pit3k/domofon-esp32/hardware/pcb/drc-report.txt

** Drc report for domofon.kicad_pcb **
** Created on 2026-10-20T21:28:56+0200 **

** Found 0 DRC violations **

** Found 0 unconnected pads **

** Found 0 Footprint errors **

** End of Report **
