pit3k/domofon-esp32/cnc/previews/toolpaths_overview.png

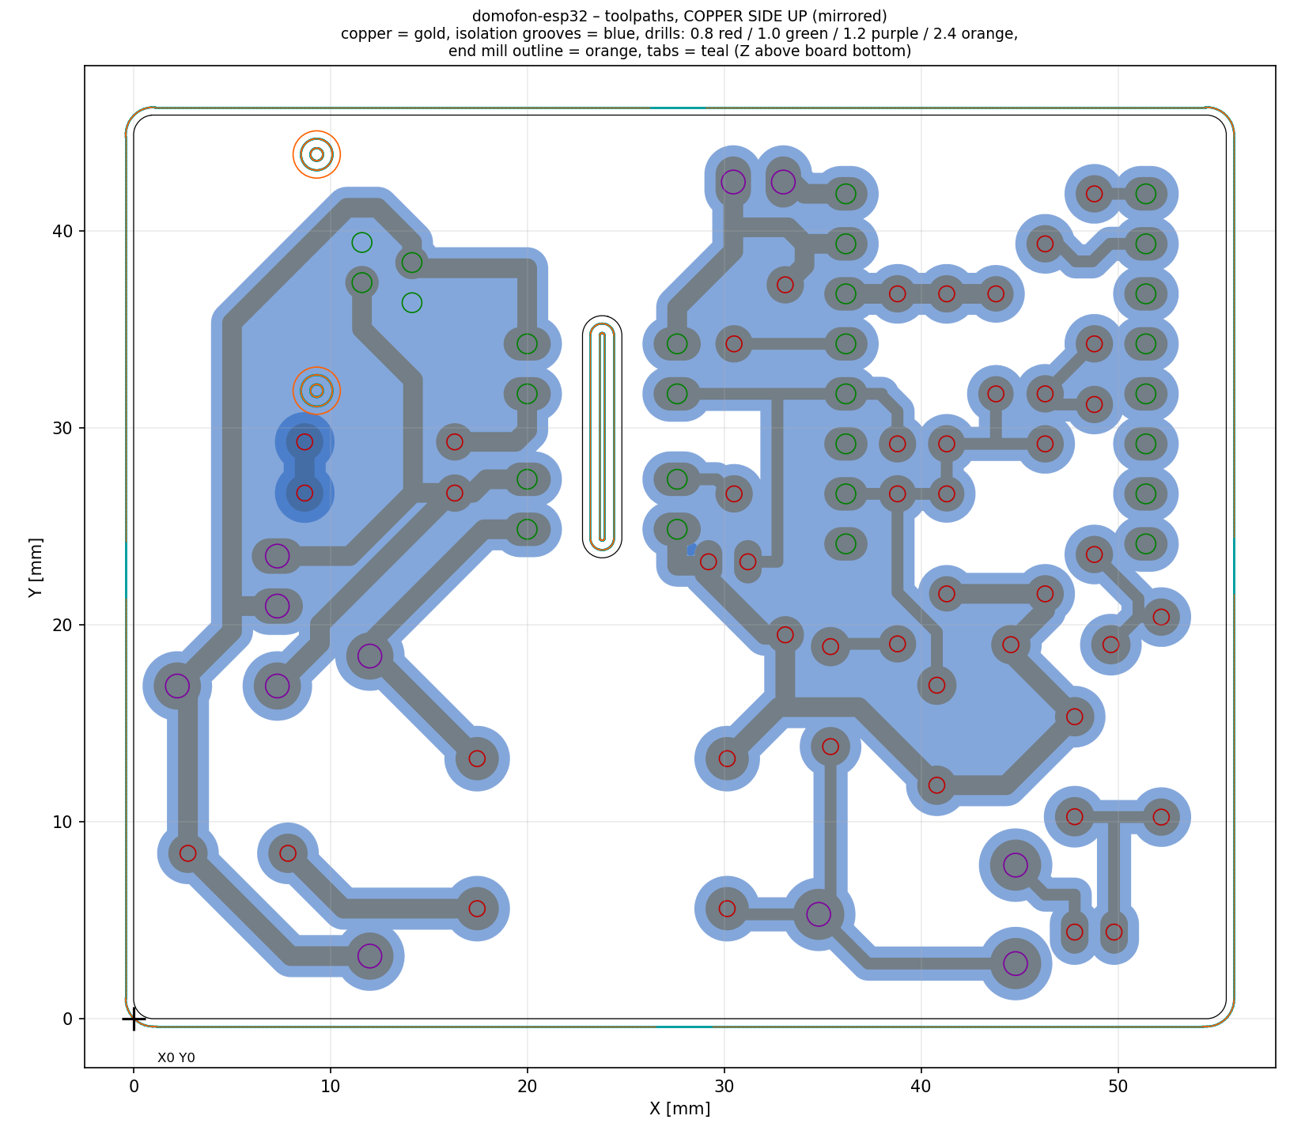
cnc/previews/toolpaths_overview.png
