pit3k/domofon-esp32/cnc/previews/toolpaths_zoom_isolation.png

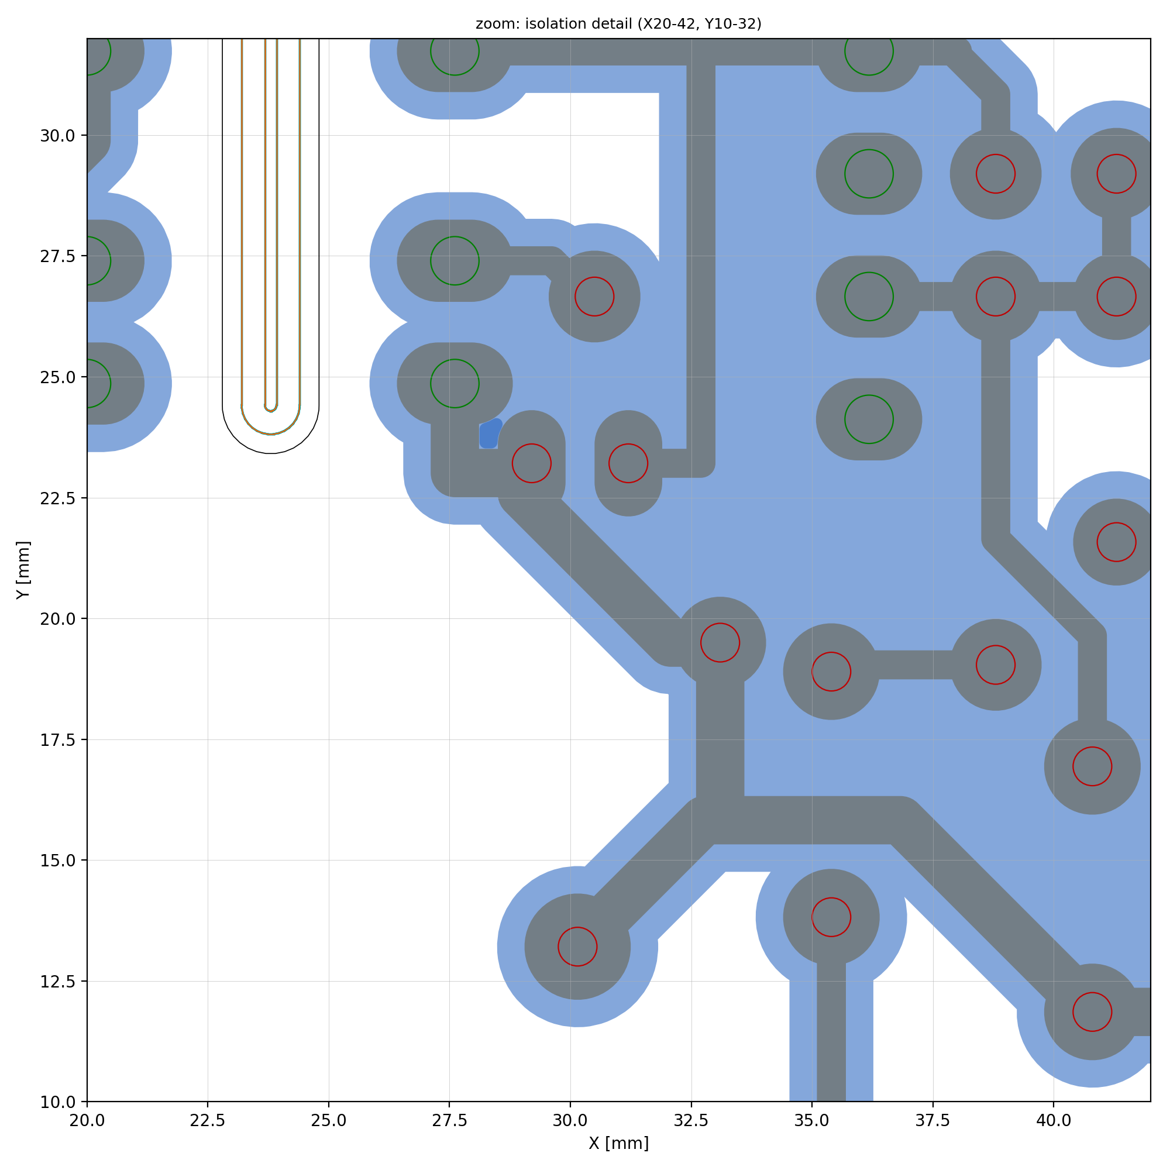
cnc/previews/toolpaths_zoom_isolation.png
