pit3k/domofon-esp32/hardware/enclosure/previews/back_view_wall_hole.png

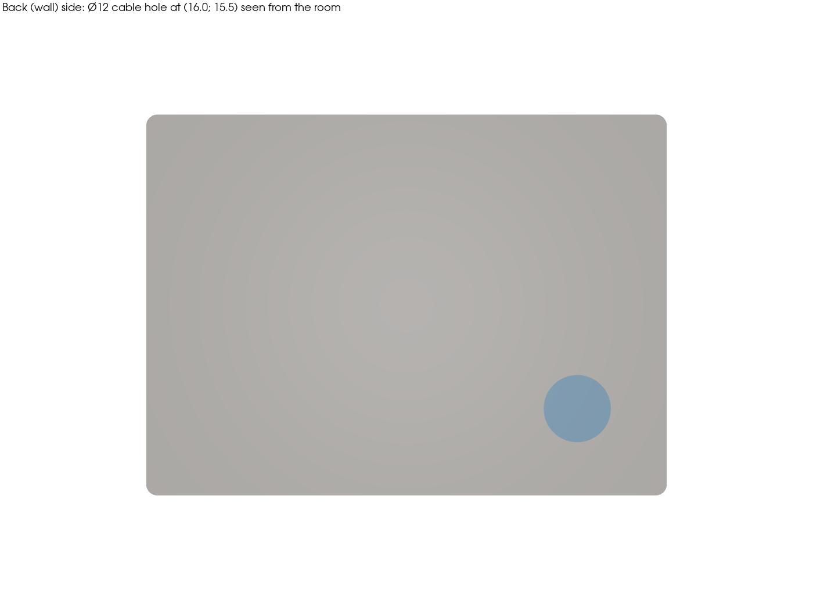
hardware/enclosure/previews/back_view_wall_hole.png
