pit3k/domofon-esp32/hardware/enclosure/previews/base_only.png

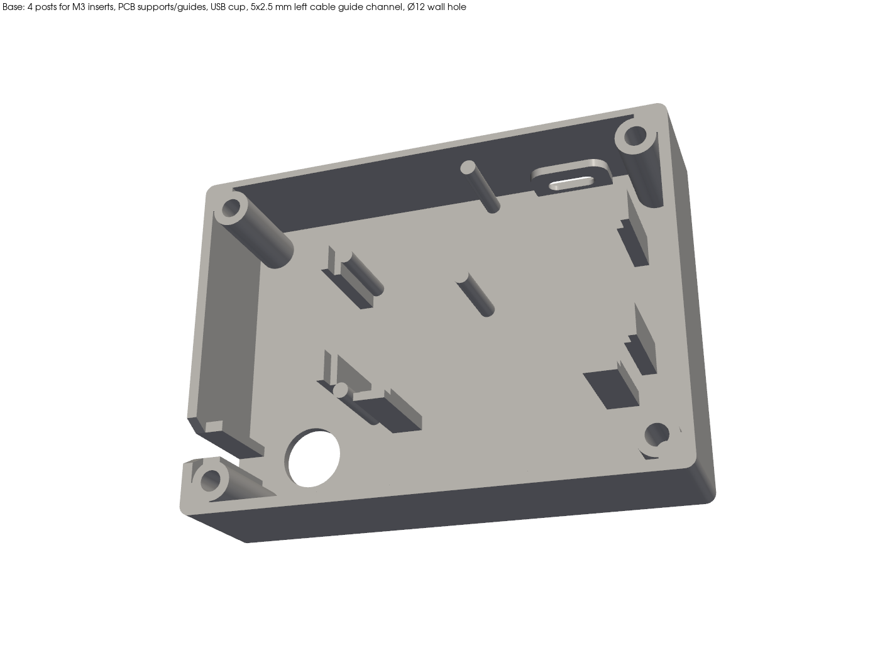
hardware/enclosure/previews/base_only.png
