pit3k/domofon-esp32/hardware/enclosure/previews/exploded.png

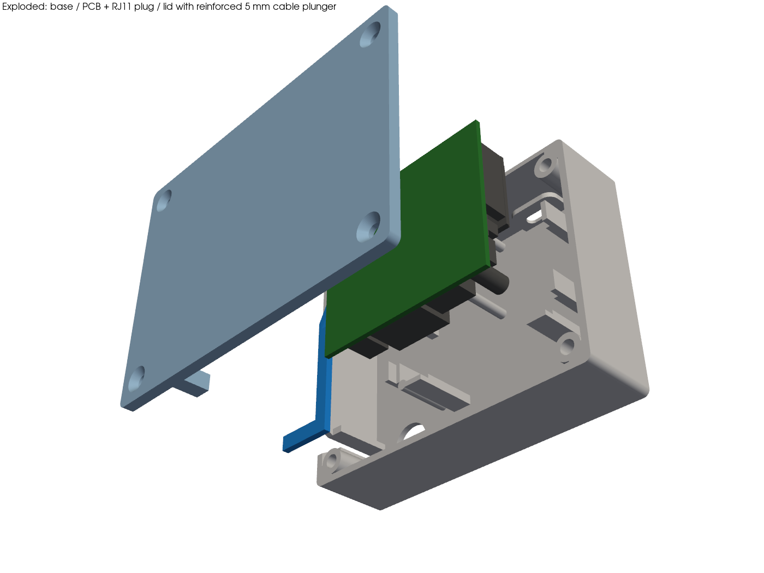
hardware/enclosure/previews/exploded.png
