pit3k/domofon-esp32/hardware/enclosure/previews/top_view_usb_pocket.png

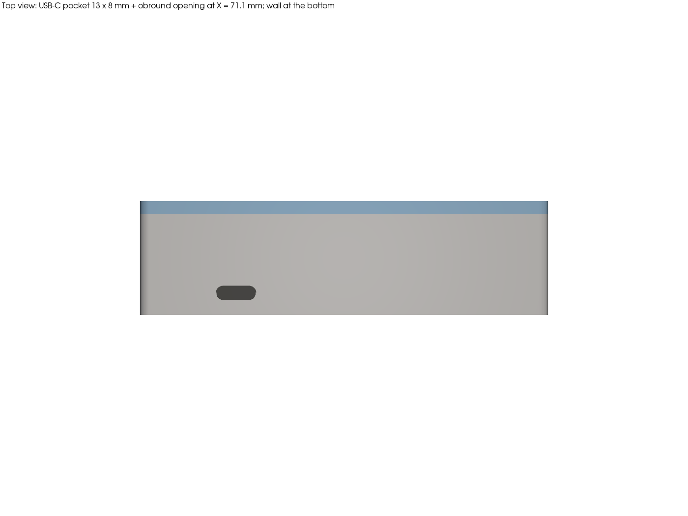
hardware/enclosure/previews/top_view_usb_pocket.png
