pit3k/domofon-esp32/hardware/bom/README.md

# BOM

- [`bom.csv`](bom.csv) – current bill of materials (rev. 5: D2 P6KE220CA, C8 0.47 µF/250 V MKT in place of the former R2, K1 AQY214EH, C5 1 µF/100 V).
- [`tme-order.csv`](tme-order.csv) – the **original** TME order (before rev. 5: AQY212GH, P6KE36CA, …), kept unchanged as history. Use `bom.csv` for new orders.
