pit3k/domofon-esp32/hardware/enclosure/step/enclosure_assembly_with_pcb.step

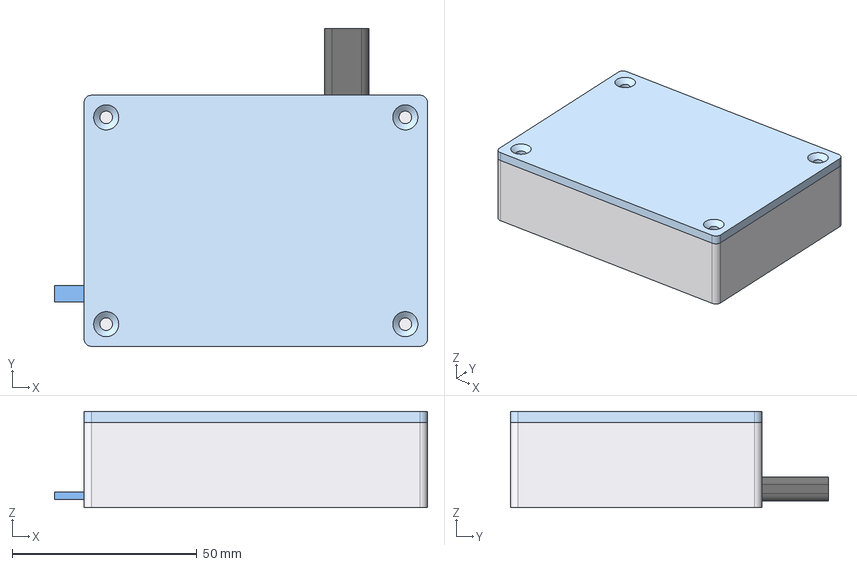
[picture p12: CAD file, 2026-10-23]
hardware/enclosure/step/enclosure_assembly_with_pcb.step
101.0 x 86.0 x 26.0 mm
base
lid
PCB
C2
T1
R8b
R10
R6a
C6
C8
D4
R6b
J1
C4
R4
C5
R9
C3
U1
C7
X2
R8a
R3
C1
K1
D5
R5
R7
D2
R1
X1
R11
ESP
usb_shell
usb_overmold
rj11_plug_cable
