pit3k/domofon-esp32/hardware/enclosure/3mf/enclosure_plate_base_and_lid.3mf

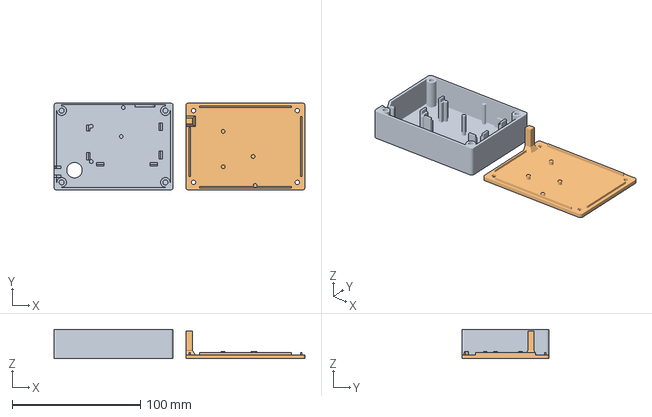
[picture p13: CAD file, 2026-10-23]
hardware/enclosure/3mf/enclosure_plate_base_and_lid.3mf
196.0 x 68.0 x 23.0 mm
base
lid
