pit3k/domofon-esp32/hardware/enclosure/step/enclosure_base.step

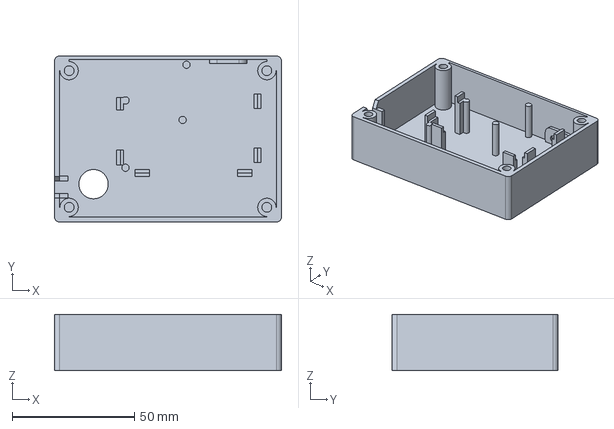
[picture p14: CAD file, 2026-10-23]
hardware/enclosure/step/enclosure_base.step
93.0 x 68.0 x 23.0 mm
