pit3k/domofon-esp32/hardware/enclosure/step/enclosure_lid.step

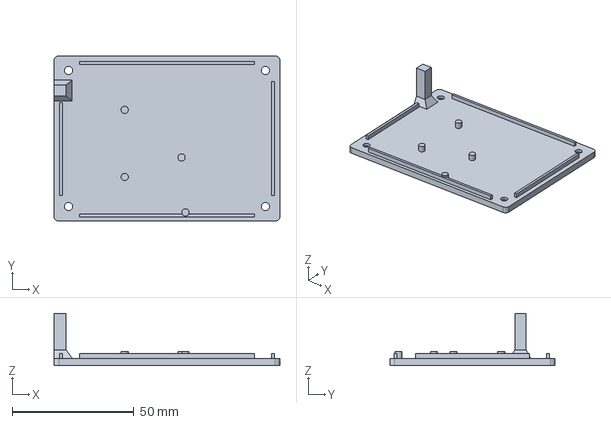
[picture p15: CAD file, 2026-10-23]
hardware/enclosure/step/enclosure_lid.step
93.0 x 68.0 x 21.5 mm
