pit3k/domofon-esp32/(list of files, cad)

Other CAD files:
hardware/enclosure/3mf/enclosure_base.3mf
hardware/enclosure/3mf/enclosure_lid.3mf
hardware/enclosure/stl/enclosure_base.stl
hardware/enclosure/stl/enclosure_lid.stl
