pit3k/domofon-esp32/hardware/enclosure/previews/assembly_front.png

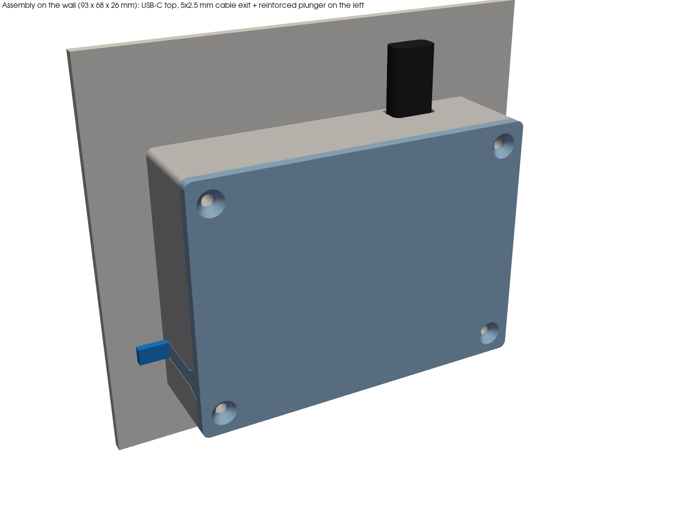
hardware/enclosure/previews/assembly_front.png
