pit3k/domofon-esp32/hardware/pcb/domofon.kicad_pcb

## KiCad design hardware/pcb/domofon.kicad_pcb (2026-10-20)

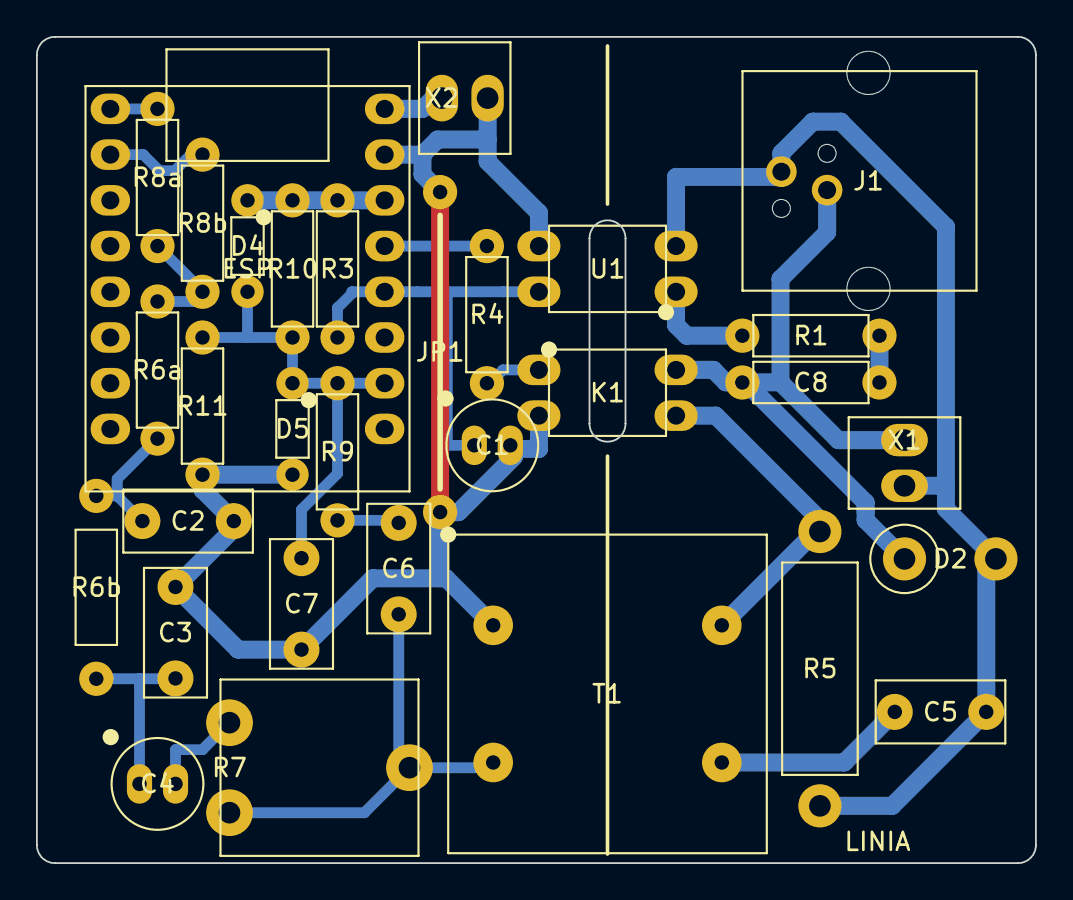
[picture p17: board domofon.kicad_pcb from above]

Board: 2 copper layers, 55.5 x 45.9 mm, 31 parts (0 on the bottom side), 21 nets.

Parts:
C1: 10u/25V; CP_D5_P2.0
C2, C3, C6: 220n; CFILM_P5.08
C4: 10u/16V NP; CP_D5_P2.0
C5: 1u/100V; CFILM_P5.08
C7: 33n; CFILM_P5.08
C8: 470n/250V; CFILM_P7.62
D2: P6KE220CA; DO15_P5.08_V
D4, D5: BAT85; DO34_P5.08
ESP: ESP32-C3 SuperMini HW-466B; ESP
J1: MTJ-642BX2; MTJ642
JP1: zworka drut; WIRE_P10.16
K1: AQY214EH; DIP4
R1, R10, R11: 4k7; R0207_P7.62
R3: 10k; R0207_P7.62
R4: 330; R0207_P7.62
R5: 330 1W; R0414_P15.24
R6a: 100R; R0207_P7.62
R6b: 100R; R0207_P10.16
R7: 4k7 CA9V; CA9V
R8a, R8b: 330R; R0207_P7.62
R9: 2k2; R0207_P7.62
T1: LM-NP-1001-B1L; T1
U1: LTV-814; DIP4
X1: XY308-2P LINIA; XY308_2P
X2: XY308-2P 5V/GND; XY308_2P

Connections:
+3V3: D4.1, ESP.R3, R3.2, R10.1
+5V: ESP.R1, X2.1
A: R6a.1, R8a.2, R8b.2
B: C2.1, R6a.2, R6b.1
C: C3.1, C4.1, R6b.2
D: C6.1, R7.2, R7.3, T1.4
GND: C1.2, C2.2, C3.2, C7.2, D5.2, ESP.R2, JP1.1, JP1.2, K1.2, R11.2, T1.1, U1.3, X2.2
GPIO1: C7.1, D4.2, D5.1, ESP.R7, R9.2, R10.2, R11.1
GPIO3: C1.1, ESP.R5, R3.1, U1.4
GPIO4: ESP.R4, R4.1
GPIO5: ESP.L1, R8a.1
GPIO6: ESP.L2, R8b.1
H: K1.3, R5.1, T1.8
L1: C8.1, D2.1, J1.2, K1.4, X1.1
L2: C5.2, D2.2, J1.3, R5.2, U1.2, X1.2
N_C4: C4.2, R7.1
N_C6: C6.2, R9.1
N_C8R1: C8.2, R1.1
N_K1A: K1.1, R4.2
N_T1C5: C5.1, T1.5
N_U1A: R1.2, U1.1
