pit3k/domofon-esp32/firmware/esphome/domofon.yaml

# ESP32-C3 SuperMini (HW-466B)
# Sekrety: skopiuj secrets.yaml.example -> secrets.yaml
# Komponenty: firmware/esphome/components/ (pobierane z gita, ref: ${git_ref})
#
# GPIO5 = ton niski, GPIO6 = ton wysoki (sumator R8a/R8b).
# Sekwencje: 0-9 * # A-D, spacja ignorowana, przecinek = pauza.
# Przyklad: "1", "1234#", "9,123"

substitutions:
  # Wersja firmware i komponentow; w pakiecie z HA ustawiana tez w packages.
  git_ref: main
  ha_url: "http://homeassistant.local:8123"
  ha_token: !secret ha_token

esp32:
  variant: esp32c3
  flash_size: 4MB
  framework:
    type: esp-idf

logger:

external_components:
  # Git (not local), so the file also works when pulled in via `packages:` from
  # Home Assistant, where only YAML files are fetched.
  - source:
      type: git
      url: https://github.com/pit3k/domofon-esp32
      ref: ${git_ref}
      path: firmware/esphome/components
    refresh: 0s
    components: [dtmf_tone, dtmf_decoder]

dtmf_decoder:
  id: dtmf
  pin: GPIO1
  enabled: true
  sample_rate: 8000
  block_size: 205
  min_amplitude: 25
  max_twist: 8dB
  min_group_ratio: 6dB
  min_tone_energy_ratio: 0.4
  min_on_blocks: 2
  min_off_blocks: 2
  sequence_timeout: 3s
  debug: false
  last_digit:
    name: "Domofon DTMF ostatnia cyfra"
  sequence:
    name: "Domofon DTMF sekwencja"
  on_digit:
    - event.trigger:
        id: dtmf_event
        event_type: !lambda "return x;"

dtmf_tone:
  id: dtmf_gen
  pin_low: GPIO5
  pin_high: GPIO6
  carrier_frequency: 200000
  sample_rate: 32000
  amplitude: 100%
  voice_amplitude: 400%  # tylko glos/WAV, nie DTMF
  high_tone_level: 80%
  wav_sample_rate: 8000
  # Glos jest generowany podczas kompilacji przez TTS (Piper) w Home Assistant.
  home_assistant:
    url: ${ha_url}
    token: ${ha_token}
  wavs:
    - name: enter_code
      tts: {text: "Wprowadź kod", voice: pl_PL-darkman-medium}
    - name: opening_door
      tts: {text: "Otwieram drzwi", voice: pl_PL-darkman-medium}
    - name: code_invalid
      tts: {text: "Kod nieprawidłowy", voice: pl_PL-darkman-medium}
    - name: ringback
      tone: {frequency: 425, on_time: 1s, off_time: 4s}

event:
  - platform: template
    id: dtmf_event
    name: "Domofon DTMF"
    event_types: ["0", "1", "2", "3", "4", "5", "6", "7", "8", "9", "*", "#", "A", "B", "C", "D"]

binary_sensor:
  - platform: gpio
    name: "Domofon dzwonek"
    pin: { number: GPIO3, inverted: true, mode: { input: true, pullup: true } }
    filters:
      - delayed_on: 50ms
      - delayed_off: 1500ms

  - platform: template
    id: dtmf_audio_playing
    name: "Domofon audio aktywne"
    entity_category: diagnostic
    lambda: |-
      return id(dtmf_gen).is_playing();

globals:
  # millis() when the line went off-hook. 0 means on-hook.
  - id: offhook_since_ms
    type: uint32_t
    initial_value: "0"
  # Which one-shot clip owns the generator. 0 = none.
  # 1 enter_code, 2 opening_door, 3 code_invalid, 4 gate DTMF.
  # Ringback is not tracked here: that switch stays on until it is turned off.
  - id: active_clip
    type: int
    initial_value: "0"
  # Gate DTMF mutes the decoder so the device does not hear its own tones.
  - id: gate_decoder_paused
    type: bool
    initial_value: "false"

interval:
  # Hang up no matter what took the line off-hook (manual switch, automation, script).
  - interval: 1s
    then:
      - if:
          condition:
            and:
              - switch.is_on: offhook
              - lambda: |-
                  const uint32_t limit_ms = (uint32_t) (id(offhook_max_s).state * 1000.0f);
                  return id(offhook_since_ms) != 0 && (millis() - id(offhook_since_ms)) >= limit_ms;
          then:
            - logger.log:
                format: "Off-hook limit reached (%.0f s), forcing on-hook"
                args: ["id(offhook_max_s).state"]
            - switch.turn_off: offhook

  # One-shot switches follow active_clip && is_playing(), so they drop on their
  # own when audio stops. Clear the stale owner here, and re-enable the decoder
  # if the gate sequence had paused it. Ringback loops, so it is left alone.
  - interval: 100ms
    then:
      - if:
          condition:
            lambda: "return id(active_clip) != 0 && !id(dtmf_gen).is_playing();"
          then:
            - lambda: "id(active_clip) = 0;"
      - if:
          condition:
            lambda: "return id(gate_decoder_paused) && !id(dtmf_gen).is_playing();"
          then:
            - script.execute: release_gate_decoder

switch:
  - platform: gpio
    id: offhook
    name: "Domofon off-hook"
    pin: GPIO4
    restore_mode: ALWAYS_OFF
    on_turn_on:
      - lambda: "id(offhook_since_ms) = millis();"
      - dtmf_decoder.enable: dtmf
    on_turn_off:
      - lambda: |-
          id(offhook_since_ms) = 0;
          id(active_clip) = 0;
          id(gate_decoder_paused) = false;
      - switch.turn_off: ringback_loop
      - dtmf_tone.stop: dtmf_gen
      - dtmf_decoder.disable: dtmf
      - dtmf_decoder.clear_sequence: dtmf

  - platform: template
    id: ringback_loop
    name: "Domofon sygnał oczekiwania"
    optimistic: true
    # Stays on for the whole wait. It does not clear itself when a loop
    # iteration ends. Hangup (including the off-hook time limit) turns it off.
    turn_on_action:
      - lambda: "id(active_clip) = 0;"
      - script.execute: release_gate_decoder
      - dtmf_tone.play_wav:
          id: dtmf_gen
          name: ringback
          loop: true
          preroll_ms: 0ms
    turn_off_action:
      # turn_off always runs the action, even if the switch was already off.
      # Stop audio only when this switch was actually on, so a redundant
      # turn_off does not cut off a voice clip or the gate tones.
      - if:
          condition:
            switch.is_on: ringback_loop
          then:
            - dtmf_tone.stop: dtmf_gen

  # One-shot clips. Turning the switch on starts playback. The lambda reports
  # on only while that clip owns the generator, so the switch turns itself off
  # when the sound finishes (or when another clip takes over). Turning it off
  # early stops playback. None of these touch the off-hook relay.
  - platform: template
    id: wav_enter_code
    name: "Domofon głos: wprowadź kod"
    restore_mode: ALWAYS_OFF
    optimistic: true
    lambda: |-
      if (id(active_clip) == 1 && id(dtmf_gen).is_playing()) return true;
      return false;
    turn_on_action:
      - script.execute:
          id: play_voice_clip
          clip_id: 1
          wav_name: enter_code
    turn_off_action:
      - script.execute:
          id: stop_clip_if_owner
          clip_id: 1
  - platform: template
    id: wav_opening_door
    name: "Domofon głos: otwieram drzwi"
    restore_mode: ALWAYS_OFF
    optimistic: true
    lambda: |-
      if (id(active_clip) == 2 && id(dtmf_gen).is_playing()) return true;
      return false;
    turn_on_action:
      - script.execute:
          id: play_voice_clip
          clip_id: 2
          wav_name: opening_door
    turn_off_action:
      - script.execute:
          id: stop_clip_if_owner
          clip_id: 2
  - platform: template
    id: wav_code_invalid
    name: "Domofon głos: kod nieprawidłowy"
    restore_mode: ALWAYS_OFF
    optimistic: true
    lambda: |-
      if (id(active_clip) == 3 && id(dtmf_gen).is_playing()) return true;
      return false;
    turn_on_action:
      - script.execute:
          id: play_voice_clip
          clip_id: 3
          wav_name: code_invalid
    turn_off_action:
      - script.execute:
          id: stop_clip_if_owner
          clip_id: 3
  - platform: template
    id: gate_open
    name: "Domofon otwórz furtkę"
    restore_mode: ALWAYS_OFF
    optimistic: true
    lambda: |-
      if (id(active_clip) == 4 && id(dtmf_gen).is_playing()) return true;
      return false;
    turn_on_action:
      - if:
          condition:
            switch.is_on: ringback_loop
          then:
            - switch.turn_off: ringback_loop
      - lambda: |-
          id(active_clip) = 4;
          id(gate_decoder_paused) = true;
      - dtmf_decoder.disable: dtmf
      - dtmf_tone.play:
          id: dtmf_gen
          sequence: !lambda "return id(gate_dtmf_sequence).state;"
          tone_length: !lambda "return (uint32_t) id(gate_tone_duration_ms).state;"
          inter_digit_gap: !lambda "return (uint32_t) id(gate_inter_digit_gap_ms).state;"
    turn_off_action:
      - script.execute:
          id: stop_clip_if_owner
          clip_id: 4
      - script.execute: release_gate_decoder

text:
  - platform: template
    id: gate_dtmf_sequence
    name: "Brama - sekwencja DTMF"
    entity_category: config
    mode: text
    min_length: 1
    max_length: 32
    initial_value: "1"
    optimistic: true
    restore_value: true

number:
  - platform: template
    id: gate_tone_duration_ms
    name: "Brama - czas nadawania tonu"
    entity_category: config
    unit_of_measurement: "ms"
    mode: box
    min_value: 100
    max_value: 30000
    step: 100
    initial_value: 3000
    optimistic: true
    restore_value: true
  - platform: template
    id: gate_inter_digit_gap_ms
    name: "Brama - przerwa miedzy tonami"
    entity_category: config
    unit_of_measurement: "ms"
    mode: box
    min_value: 0
    max_value: 2000
    step: 10
    initial_value: 80
    optimistic: true
    restore_value: true
  - platform: template
    id: offhook_max_s
    name: "Domofon - maks. czas off-hook"
    entity_category: config
    unit_of_measurement: "s"
    mode: box
    min_value: 10
    max_value: 3600
    step: 1
    initial_value: 60
    optimistic: true
    restore_value: true

script:
  # Re-enable the decoder after gate DTMF, but only while the line is still off-hook.
  - id: release_gate_decoder
    mode: single
    then:
      - if:
          condition:
            lambda: "return id(gate_decoder_paused);"
          then:
            - lambda: "id(gate_decoder_paused) = false;"
            - if:
                condition:
                  switch.is_on: offhook
                then:
                  - dtmf_decoder.enable: dtmf

  - id: stop_clip_if_owner
    mode: single
    parameters:
      clip_id: int
    then:
      - if:
          condition:
            lambda: "return id(active_clip) == clip_id;"
          then:
            - lambda: "id(active_clip) = 0;"
            - dtmf_tone.stop: dtmf_gen

  - id: play_voice_clip
    mode: restart
    parameters:
      clip_id: int
      wav_name: string
    then:
      - if:
          condition:
            switch.is_on: ringback_loop
          then:
            - switch.turn_off: ringback_loop
      - lambda: "id(active_clip) = clip_id;"
      - dtmf_tone.stop: dtmf_gen
      - script.execute: release_gate_decoder
      - dtmf_tone.play_wav:
          id: dtmf_gen
          name: !lambda "return wav_name;"

button:
  - platform: template
    name: "Domofon wyczyść sekwencję DTMF"
    on_press:
      - dtmf_decoder.clear_sequence: dtmf
