pit3k/domofon-esp32/hardware/pcb/scripts/netlist.py

# Netlist per docs/design-notes-pl.md (schematic v4). Pin-swaps of electrically equivalent pins marked [swap].
NETS = {
 # ---- line side (isolated) ----
 'L1':    [('X1','1'),('J1','2'),('D2','1'),('C8','1'),('K1','4')],
 'L2':    [('X1','2'),('J1','3'),('D2','2'),('U1','2'),('R5','2'),('C5','2')],
 'N_C8R1': [('C8','2'),('R1','1')],
 'N_U1A': [('R1','2'),('U1','1')],
 'H':     [('K1','3'),('R5','1'),('T1','8')],   # [swap] T1 line winding ends 5/8 interchangeable (schematic/docs match PCB: T1.8=H, T1.5=C5)
 'N_T1C5':[('T1','5'),('C5','1')],
 # ---- ESP side ----
 'GND':   [('ESP','R2'),('X2','2'),('U1','3'),('C1','2'),('K1','2'),('C2','2'),('C3','2'),('T1','1'),('R11','2'),('C7','2'),('D5','2'),('JP1','1'),('JP1','2')],
 '+3V3':  [('ESP','R3'),('R3','2'),('R10','1'),('D4','1')],
 '+5V':   [('ESP','R1'),('X2','1')],
 'GPIO3': [('ESP','R5'),('U1','4'),('R3','1'),('C1','1')],
 'GPIO4': [('ESP','R4'),('R4','1')],
 'N_K1A': [('R4','2'),('K1','1')],
 'GPIO5': [('ESP','L1'),('R8a','1')],
 'GPIO6': [('ESP','L2'),('R8b','1')],
 'A':     [('R8a','2'),('R8b','2'),('R6a','1')],
 'B':     [('R6a','2'),('R6b','1'),('C2','1')],
 'C':     [('R6b','2'),('C3','1'),('C4','1')],
 'N_C4':  [('C4','2'),('R7','1')],
 'D':     [('R7','2'),('R7','3'),('T1','4'),('C6','1')],   # [swap] T1 ESP winding ends 1/4 interchangeable (schematic: T1.1=D, T1.4=GND)
 'N_C6':  [('C6','2'),('R9','1')],
 'GPIO1': [('R9','2'),('R10','2'),('R11','1'),('C7','1'),('D4','2'),('D5','1'),('ESP','R7')],
}
LINE_NETS = ['L1','L2','N_C8R1','N_U1A','H','N_T1C5']
POWER_NETS = ['GND','+3V3','+5V']

PARTS = {  # ref: (footprint, value)
 'JP1':('WIRE_P10.16','zworka drut'),
 'ESP':('ESP','ESP32-C3 SuperMini HW-466B'),
 'U1':('DIP4','LTV-814'), 'K1':('DIP4','AQY214EH'), 'T1':('T1','LM-NP-1001-B1L'),
 'R1':('R0207_P7.62','4k7'), 'C8':('CFILM_P7.62','470n/250V'), 'R3':('R0207_P7.62','10k'),
 'R4':('R0207_P7.62','330'), 'R5':('R0414_P15.24','330 1W'),
 'R6a':('R0207_P7.62','100R'), 'R6b':('R0207_P10.16','100R'),
 'R8a':('R0207_P7.62','330R'), 'R8b':('R0207_P7.62','330R'),
 'R9':('R0207_P7.62','2k2'), 'R10':('R0207_P7.62','4k7'), 'R11':('R0207_P7.62','4k7'),
 'R7':('CA9V','4k7 CA9V'),
 'C1':('CP_D5_P2.0','10u/25V'), 'C4':('CP_D5_P2.0','10u/16V NP'),
 'C2':('CFILM_P5.08','220n'), 'C3':('CFILM_P5.08','220n'), 'C7':('CFILM_P5.08','33n'),
 'C6':('CFILM_P5.08','220n'), 'C5':('CFILM_P5.08','1u/100V'),
 'D2':('DO15_P5.08_V','P6KE220CA'), 'D4':('DO34_P5.08','BAT85'), 'D5':('DO34_P5.08','BAT85'),
 'X1':('XY308_2P','XY308-2P LINIA'), 'X2':('XY308_2P','XY308-2P 5V/GND'),
 'J1':('MTJ642','MTJ-642BX2'),
}
