pit3k/domofon-esp32/(commit log)

2026-10-15 Initial commit: schematic, PCB, BOM, ESPHome firmware
    - hardware/schematic: schemdraw source + SVG/PNG
    - hardware/pcb: KiCad 9 single-sided THT board (DRC clean), generator scripts, Gerbers/Excellon, previews
    - hardware/bom: BOM and final TME order
    - firmware/esphome: ESPHome config + custom dtmf_decoder component
    - cnc: milling notes for PrintNC / Flexi-HAL (G-code TODO)
    - docs: design notes (EN summary + full PL)
    [bom.csv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]
2026-10-15 CNC: G-code for PrintNC/grblHAL, operator guide (PL), CAM config and verification
2026-10-15 CNC guide: 3D touch probe height-map workflow for ioSender, paper Z-zero for tool changes
2026-10-15 CNC: switch end mill to 0.8 mm (files 05/06), concentric passes for slot and 2.4 mm holes, coverage checks
2026-10-15 Enclosure: parametric 3D-printed wall box (CadQuery), STL/3MF/STEP, previews, interference check
    [enclosure_assembly_with_pcb.step, enclosure_base.3mf, enclosure_base.step, enclosure_base.stl, enclosure_lid.3mf, enclosure_lid.step, enclosure_lid.stl, enclosure_plate_base_and_lid.3mf]
2026-10-20 Update DTMF transmit parts and firmware sources.
    C2/C3 are 220 nF with R6 100 Ω and R8 330 Ω (C5 stays 1 µF) so the sine PWM at 200 kHz is louder and still filtered. Firmware uses esphome-dtmf-tone and esphome-dtmf-decoder instead of the vendored decoder.
    [bom.csv, domofon.kicad_pcb]
2026-10-20 Pin dtmf_tone to the build that idles PWM.
    Incoming DTMF decode needs the generator pins quiet between bursts.
2026-10-20 Rev. 5 line side for ES 201 970: D2 P6KE220CA, C8 0.47uF/250V in R2 holes (no DC on-hook), K1 AQY214EH, C5 1uF/100V; line-voltage notes, BOM, schematic, enclosure heights
    [bom.csv, enclosure_assembly_with_pcb.step]
2026-10-20 Consistency pass rev. 5: C8 replaces R2 on PCB (same pads), K1 AQY214EH, D2 P6KE220CA, C5 1u/100V in KiCad/generators/gerbers/enclosure; docs/BOM cleanup; schematic PNG ~3200 px
    [bom.csv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]
2026-10-20 Schematic/docs: T1 line winding pins match PCB (T1.8 -> H, T1.5 -> C5); no PCB/G-code change
2026-10-22 Enclosure v7: 68x68x26 square box, PCB flipped (components to wall), RJ11 left, USB-C up with 13x8 overmold pocket (plug 6.2 mm in), 3x M3x10 countersunk + M3 4x4 inserts, wall hole (16;10.5); collis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
    [bom.csv, enclosure_assembly_with_pcb.step, enclosure_base.3mf, enclosure_base.step, enclosure_base.stl, enclosure_lid.3mf, enclosure_lid.step, enclosure_lid.stl]
2026-10-23 Update enclosure to v9 (93x68x26 mm, 4 screws, internal RJ11, 5x2.5 floor cable slot with reinforced 5 mm lid plunger)
    [bom.csv, enclosure_assembly_with_pcb.step, enclosure_base.3mf, enclosure_base.step, enclosure_base.stl, enclosure_lid.3mf, enclosure_lid.step, enclosure_lid.stl]
2026-10-28 Add voice prompts and ringback via dtmf_tone WAV playback
    Prompts are generated at compile time (HA Piper TTS, synthesized tone) and
    exposed as buttons and a looping ringback switch.
2026-10-29 Pin package and components with a single intercom_ref substitution
2026-10-29 dtmf_tone: add idle bias 128 and noise preroll before WAV playback
    [domofon.yaml, dtmf_tone.cpp, dtmf_tone.h]
2026-10-29 dtmf_tone: update voice_amplitude to 400% and add dtmf_audio_playing sensor
2026-10-30 Add a Home Assistant ESPHome OTA helper. (#12)
    tools/esphome_ota.py finds the Device Builder add-on through the Supervisor API and installs a dashboard YAML over OTA. HA_TOKEN stays in the environment.
2026-10-30 Turn one-shot intercom sounds into self-resetting switches. (#13)
    Voice prompts and the gate DTMF sequence stay on while they play and turn off when the sound ends. Ringback still loops until something turns it off, including the off-hook time limit. Action play() methods take const references so they compile inside parameterized scripts on current ESPHome.
    [domofon.yaml, dtmf_tone.h]
2026-10-30 Przywróć odbiór DTMF na off-hook (#14)
    * Restore DTMF receive while the line is off-hook.
    Idle midscale bias was a 200 kHz carrier on the same transformer the ADC
    listens to, and ESP32-C3 DMA channel tags were discarding every sample.
    A diagnostic button transmits a short 5 with the decoder left enabled.
    * Remove the unused dtmf_tone.bias action.
    Nothing enables idle midscale anymore, and holding it drowned DTMF
    receive. Idle output stays at duty 0.
    * Remove the DTMF decoder test button.
    Open-gate already transmits a sequence for checks. Drop the leftover
    comments about idle midscale bias.
    Co-a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
    [domofon.yaml, dtmf_decoder.cpp, dtmf_decoder.h, dtmf_tone.cpp, dtmf_tone.h]
